Wilfred-Swinkels/ESP32-CW-ID-generator-and-BT-PTT/3Dmodels/hc-series_asm.stp

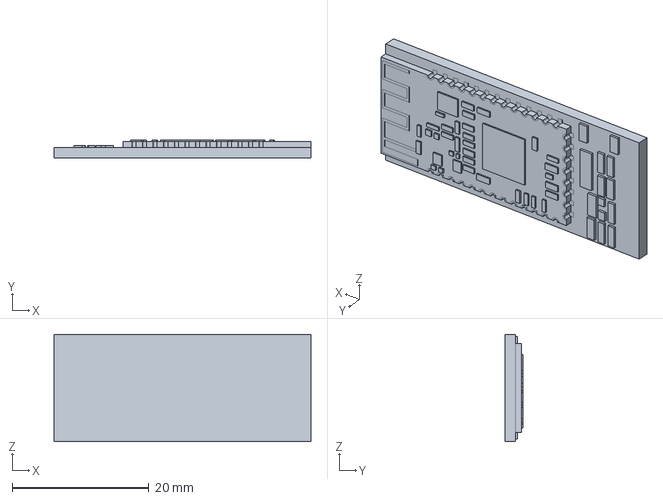
[picture p11: CAD file, 2026-10-26]
3Dmodels/hc-series_asm.stp
37.6 x 2.60 x 15.7 mm
ASSEMBLY8_ASM
