Wilfred-Swinkels/ESP32-CW-ID-generator-and-BT-PTT/3Dmodels/3-top-bt-ptt.stl

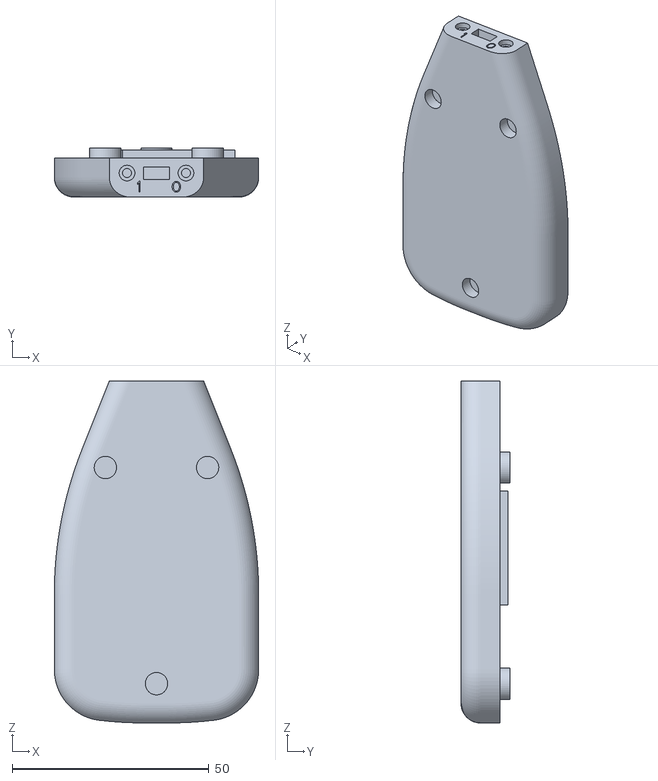
[picture p12: CAD file, 2026-10-26]
3Dmodels/3-top-bt-ptt.stl
52.0 x 12.5 x 87.0
