Wilfred-Swinkels/ESP32-CW-ID-generator-and-BT-PTT/3Dmodels/2-ptt-knob-bt-ptt.stl

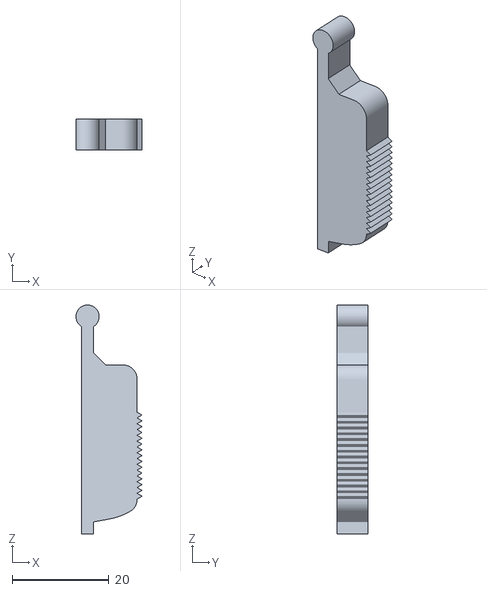
[picture p13: CAD file, 2026-10-26]
3Dmodels/2-ptt-knob-bt-ptt.stl
13.7 x 6.50 x 47.4
