Wilfred-Swinkels/ESP32-CW-ID-generator-and-BT-PTT/3Dmodels/microswitch.stp

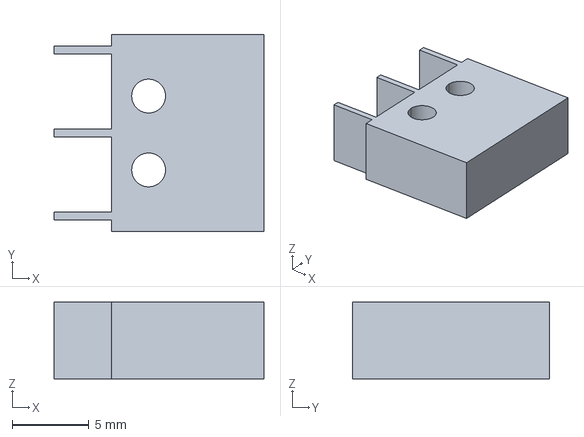
[picture p14: CAD file, 2026-10-26]
3Dmodels/microswitch.stp
13.6 x 12.8 x 5.00 mm
