Wilfred-Swinkels/ESP32-CW-ID-generator-and-BT-PTT/3Dmodels/slideswitch-new.stp

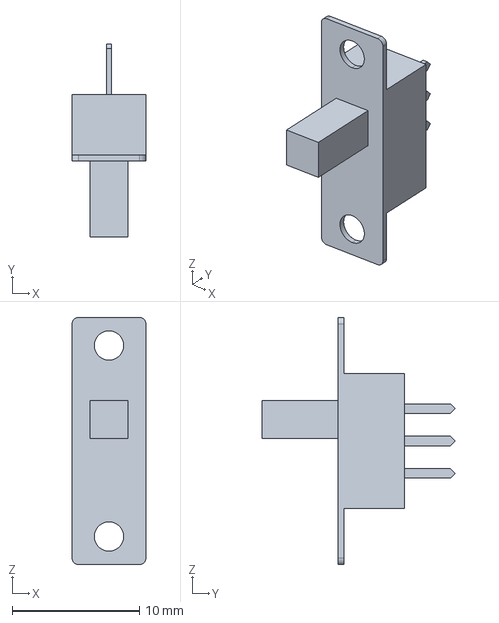
[picture p15: CAD file, 2026-10-26]
3Dmodels/slideswitch-new.stp
5.80 x 15.2 x 19.4 mm
