Wilfred-Swinkels/ESP32-CW-ID-generator-and-BT-PTT/3Dmodels/tp4056.stp

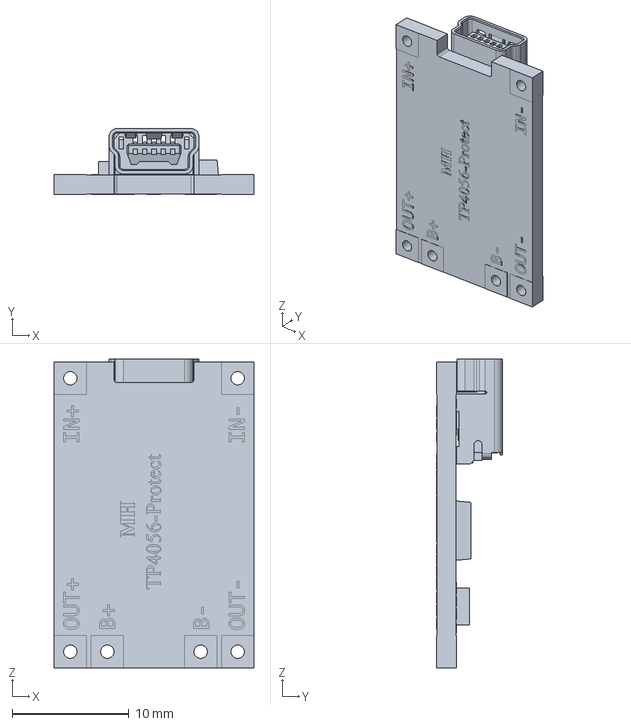
[picture p16: CAD file, 2026-10-26]
3Dmodels/tp4056.stp
17.1 x 5.66 x 26.5 mm
