Wilfred-Swinkels/ESP32-CW-ID-generator-and-BT-PTT/3Dmodels/1- bottom-BT-PTT.stp

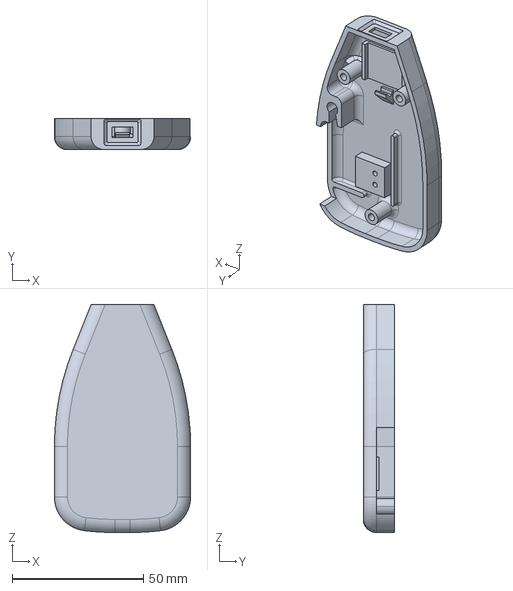
[picture p17: CAD file, 2026-10-26]
3Dmodels/1- bottom-BT-PTT.stp
52.0 x 12.0 x 87.0 mm
