Wilfred-Swinkels/ESP32-CW-ID-generator-and-BT-PTT/3Dmodels/micoswitch-lever.stp

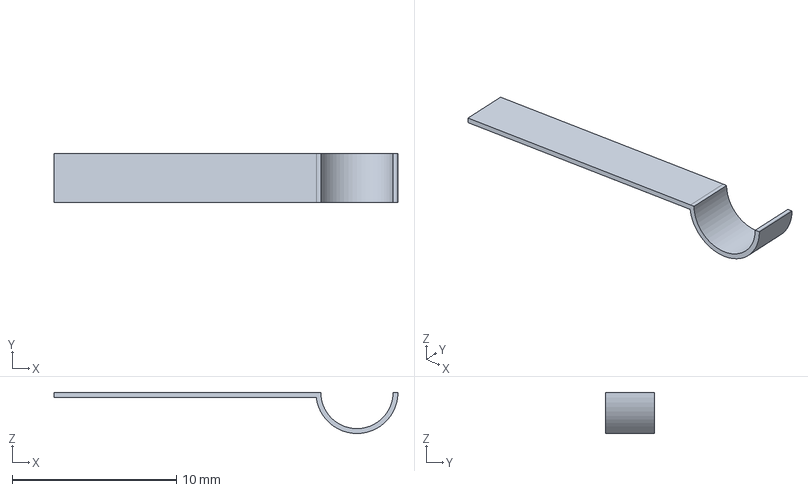
[picture p18: CAD file, 2026-10-26]
3Dmodels/micoswitch-lever.stp
20.9 x 3.00 x 2.50 mm
