Wilfred-Swinkels/ESP32-CW-ID-generator-and-BT-PTT/(list of files, cad)

Other CAD files:
3Dmodels/2- top-BT-PTT.stp
3Dmodels/3- ptt-knob-BT-PTT.stp
3Dmodels/1-bottom-bt-ptt.stl
