Wilfred-Swinkels/ESP32-CW-ID-generator-and-BT-PTT/images/wiring-hm10-pio3-pulldown-1.jpg

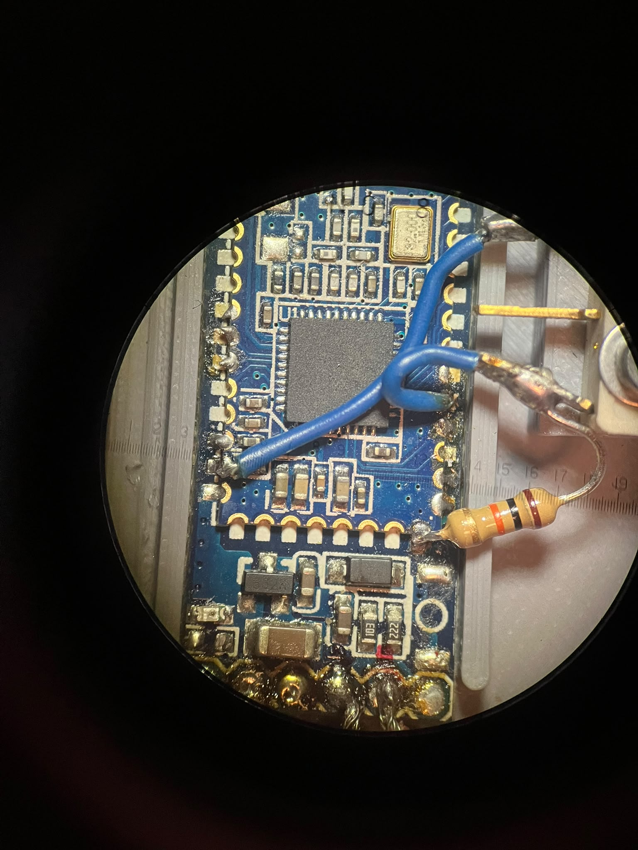
images/wiring-hm10-pio3-pulldown-1.jpg
