Wilfred-Swinkels/ESP32-CW-ID-generator-and-BT-PTT/audio_dac.h

#pragma once
#include <Arduino.h>

// Generates an analog sine tone on the ESP32's built-in 8-bit DAC
// (GPIO25 = DAC1). Only works on the "classic" ESP32 (WROOM/WROVER) -
// the ESP32-S2/S3/C3/C6 don't have an onboard DAC.
//
// Technique: a hardware timer fires an interrupt for every sample; inside
// it, a phase accumulator (DDS) is advanced and a sample is written to the
// DAC via a sine lookup table. This keeps tone generation running
// completely independently of the web server/morse logic in loop().

void audioInit();
void audioSetFrequency(uint16_t freqHz); // 400-1500 Hz (limits not enforced here)
void audioSetVolume(uint8_t volumePercent); // 0-100 %, linear amplitude

// audioToneOn()/audioToneOff() no longer switch abruptly on/off, but
// start a small attack/release envelope (smooth ramp up/down of the
// volume). That avoids the "click" (key click) you hear/hear-on-the-band
// when a tone is switched hard on/off. A true ADSR also has a
// decay/sustain stage, but those add nothing for a simple on/off-switched
// tone (the "sustain" is just full volume for as long as the tone is on)
// - hence attack + release only.
void audioToneOn();  // starts the tone (morse "key down"): smooth attack
void audioToneOff(); // stops the tone (morse "key up"): smooth release, then silence

// Make the attack/release time adjustable (in ms), so this can be changed
// via the web page instead of being a fixed compile-time value. Internally
// clamped to 1-20ms and 1-50ms respectively (see audio_dac.cpp) - those
// are also the limits the web page/sliders use.
void audioSetAttackMs(uint16_t ms);
void audioSetReleaseMs(uint16_t ms);

// Pauses/resumes the sample interrupt. Needed around flash/NVS operations
// (e.g. saving settings): during a flash write, the instruction cache is
// briefly disabled, and the interrupt calls dacWrite() (an ordinary,
// non-IRAM function) - without this pause that could, in rare cases, lead
// to a crash. Settings are only saved occasionally, so the brief
// interruption of the tone isn't audible.
void audioPause();
void audioResume();
