Wilfred-Swinkels/ESP32-CW-ID-generator-and-BT-PTT/(commit log)

2026-10-25 Initial import: ESP32 HM-10 remote PTT + CW-ID callgever firmware
    Claude-Session: https://claude.ai/code/session_01WF5UJJgGi1utjRUeBveF1n
2026-10-25 Rewrite README in English with HM-10 configuration guide (#1)
    Drop the change history and focus on what the project does, wiring,
    HM-10 setup, installation and usage.
    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
2026-10-25 Correct AT+PIO3? polling comment: it is a BLE round trip to the remote (#2)
    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
    [esp32_callgever_ptt.ino]
2026-10-25 Translate all comments/UI text to English; raise web-PTT fail-safe margin + show WiFi RSSI; widen delay/release slider ranges; rename mDNS host to esp32-BT-PTT; update default callsign
    [audio_dac.cpp, audio_dac.h, esp32_callgever_ptt.ino, morse.cpp]
2026-10-25 Pin WiFi to strongest AP via scan-first connect; delay slider now shows seconds
2026-10-26 Add MQTT publish/control with Home Assistant discovery; add enclosure 3D models and README photo
    [1- bottom-BT-PTT.stp, 2- top-BT-PTT.stp, 3- ptt-knob-BT-PTT.stp, hc-series_asm.stp, micoswitch-lever.stp, microswitch.stp, slideswitch-new.stp, tp4056.stp]
2026-10-26 Fix README point 2 (configurable delay); add TODO section; credit ON4NDO; note on HM-10 vs ESP32 BT
2026-10-26 Fix README point 2 (configurable delay); add TODO section; credit ON4NDO; note on HM-10 vs ESP32 BT; fix audio-mixing note
2026-10-26 Document battery, remote power wiring and lightpipe with photos
2026-10-26 Remove TODO.md (merged into README) and add STL exports of the 3D models
    [1-bottom-bt-ptt.stl, 2-ptt-knob-bt-ptt.stl, 3-top-bt-ptt.stl]
2026-10-26 Reorganize wiring/battery photos: group TP4056 charge-current photos with the charging TODO, pair remote overview with battery label
2026-10-26 Add missing lightpipe enclosure-hole photo
2026-10-26 Move lightpipe-glue photo next to the TP4056 charge-current resistor
2026-10-26 Note the fitted TP4056 ISET resistor value (~5.1k)
2026-10-26 Note the fitted TP4056 ISET resistor value (~5.1k), tried and tested
2026-10-26 Remove duplicate HM-10 PIO3 photo from the wiring gallery
2026-10-26 Move TP4056 charging mod and lightpipe docs out of TODO into Remote power; only the wiring diagram remains as TODO
2026-10-26 Add TODO for a base station (ESP32 side) wiring schematic
